gobbyo/picodistance/README.md

# picodistance
Pico driven distance measure

Table of Contents

1. [Overview](docs/overview.md)
1. [Parts List](docs/partslist.md)
1. [Assembly](docs/assembly.md)
