gobbyo/picodistance/docs/images/connectors.png

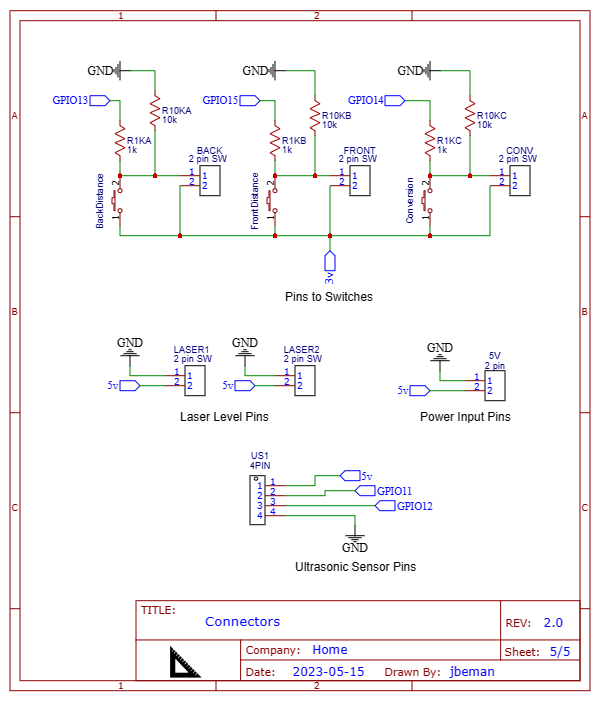
docs/images/connectors.png
