gobbyo/picodistance/docs/images/feet display.png

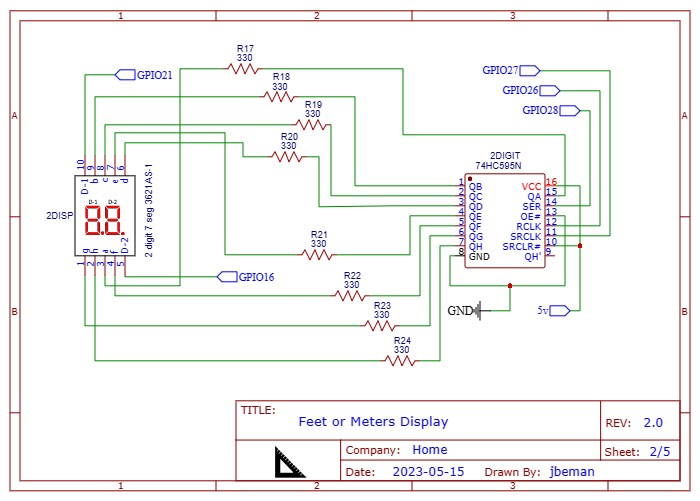
docs/images/feet display.png
