gobbyo/picodistance/docs/images/fourdigitsimple.png

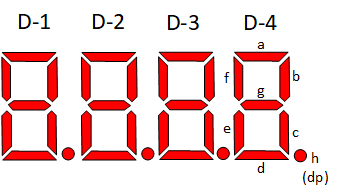
docs/images/fourdigitsimple.png
