gobbyo/picodistance/docs/images/inches display.png

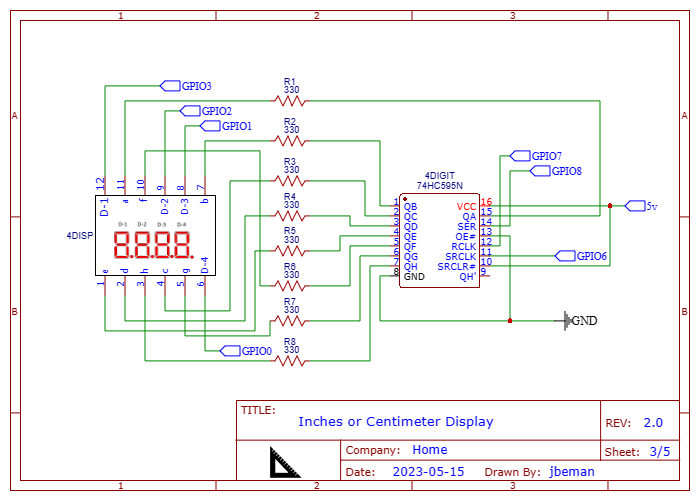
docs/images/inches display.png
