gobbyo/picodistance/docs/images/pcbbottom.png

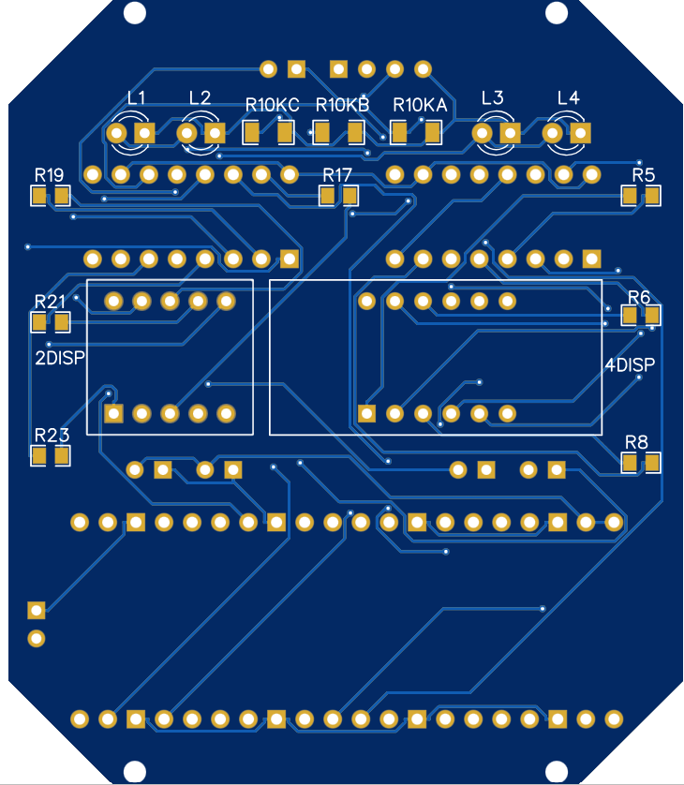
docs/images/pcbbottom.png
