gobbyo/picodistance/docs/images/pcbdimensions.png

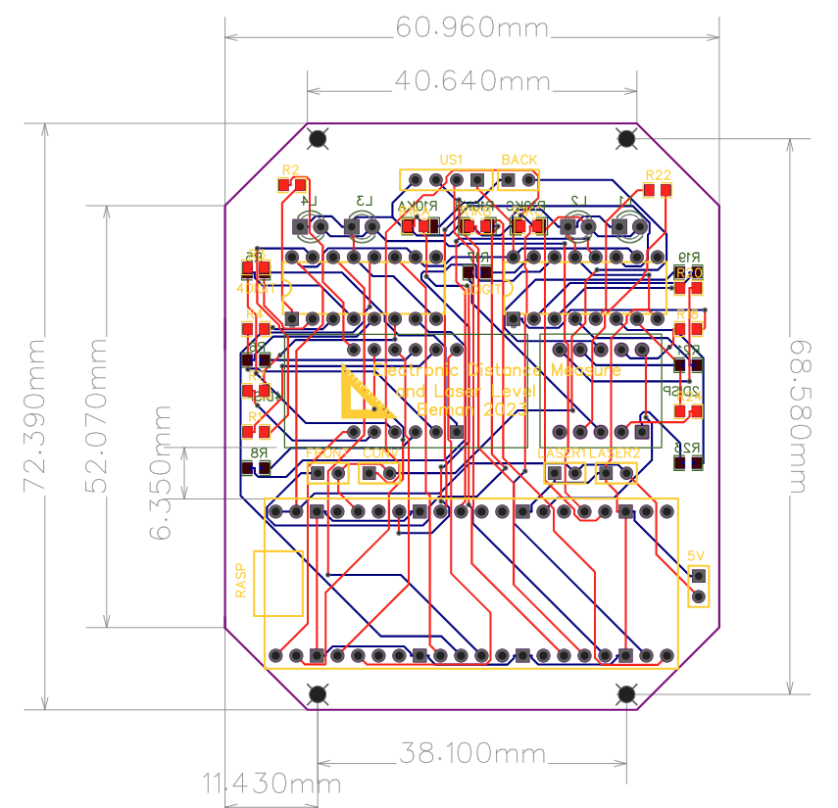
docs/images/pcbdimensions.png
