gobbyo/picodistance/docs/images/pcbtop.png

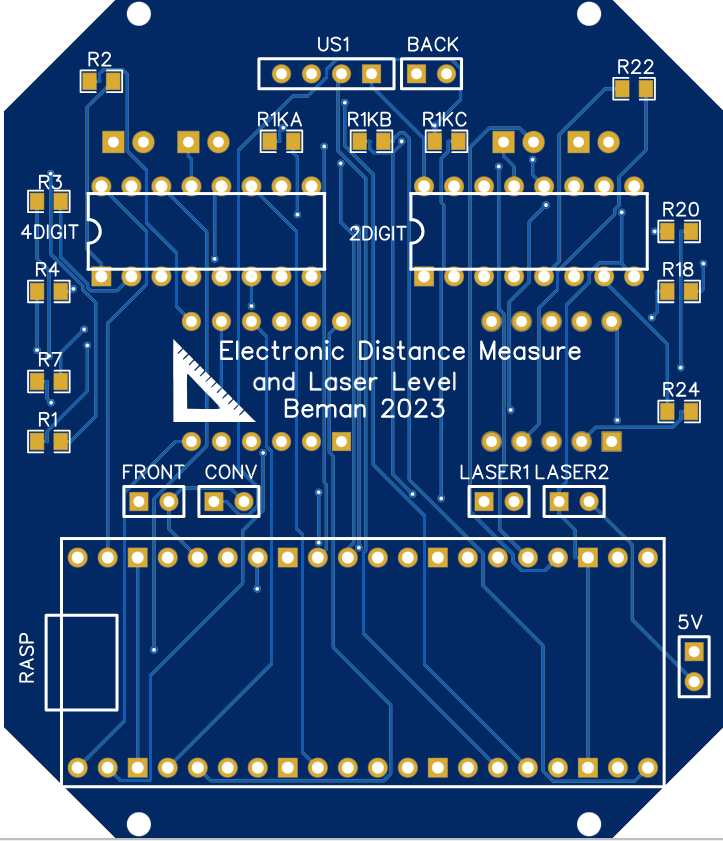
docs/images/pcbtop.png
