gobbyo/picodistance/docs/images/twodigitsimple.png

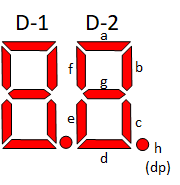
docs/images/twodigitsimple.png
