gobbyo/picodistance/docs/images/ultrasonic and battery.png

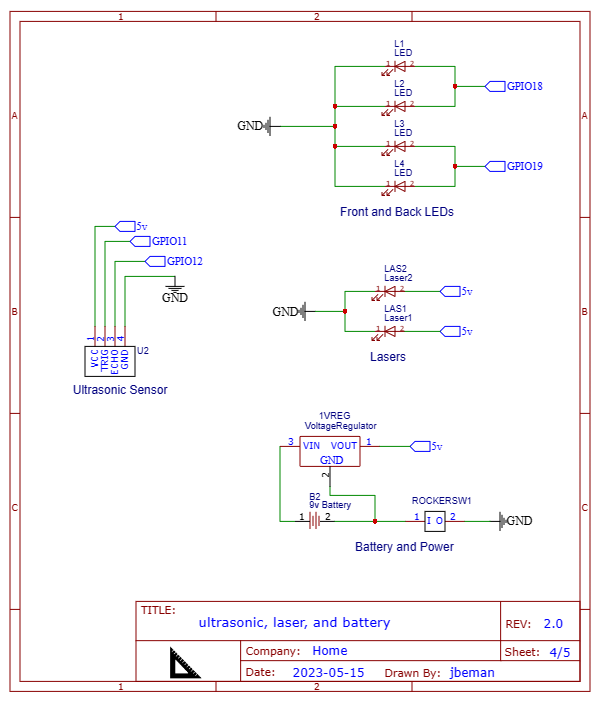
docs/images/ultrasonic and battery.png
