gobbyo/picodistance/pcb/distance-back-2023-08-4.png

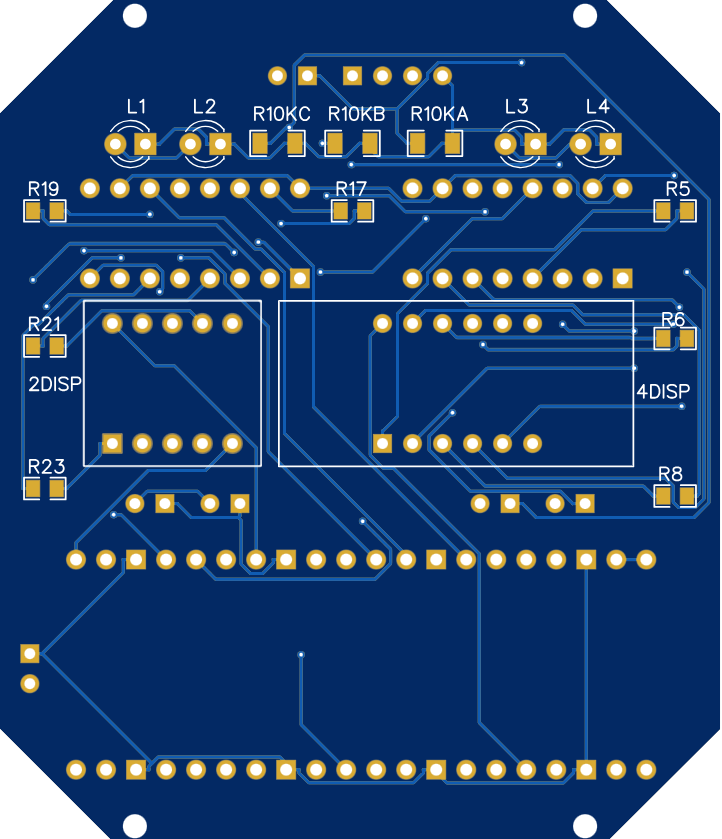
pcb/distance-back-2023-08-4.png
