gobbyo/picodistance/pcb/distance-front-2023-08-4.png

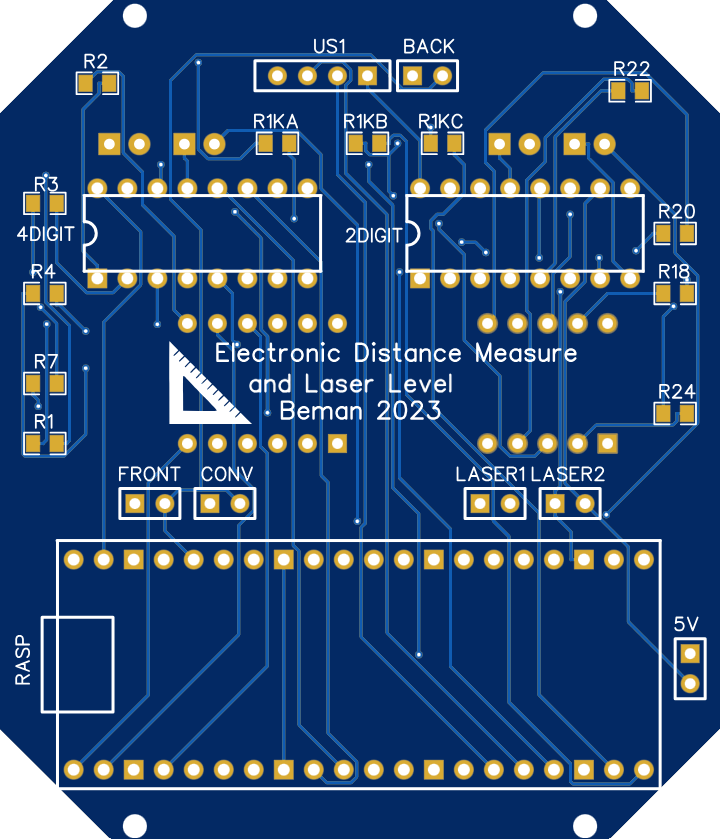
pcb/distance-front-2023-08-4.png
