gobbyo/picodistance/docs/partslist.md

# Parts List

|Item  |Model  |Quantity  |Datasheet  |
|---|---|---|---|
| Raspberry Pi Pico  | RP2040 | 1 | https://www.raspberrypi.com/products/raspberry-pi-pico/ |
| Printed Circuit Board | N/A | 1 | See PCB ordering instructions |
| LED 2-Digit 7-Segment Display 0.36"  | 3621AS | 1 | http://www.xlitx.com/datasheet/3621AS.pdf |
| LED 4-Digit 7-Segment Display 0.36" | 3641AH | 1 | http://www.xlitx.com/datasheet/3641AH.pdf |
| 5vDC voltage regulator | 7805 | 1 | https://www.eleccircuit.com/7805-5v-voltage-regulator-datasheet/ |
| 3MM flat top white LED | AA00136 |  4 | https://www.aliexpress.us/item/2251832094868310.html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 |
|Laser Transmitter 5mW 650nm Red Dot Laser Diode Module | KY-008 | 2 | https://temperosystems.com.au/products/ky-008-laser-650nm-5v-laser-diode-laser-transmitter/ |
| 8-Bit Counter Shift Registers 3-State Output Registers Integrated Circuits DIP-16  | SN74HC595N |  2 | https://www.apogeeweb.net/circuitry/sn74hc595n-pinout-datasheet-features-applications.html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 |
|Ultrasonic Module HC-SR04 Distance Sensor | HC-SR04 |  1 | https://mega.nz/folder/BlJz0T7B#dzXcwUN_xoUTOmhmVMA0sg/folder/E5BFULaB |
|12MM Momentary Push Button Switch (ON/Off) Mini Round Switch SPST 2 Pin  |  PBS-33B-M-6S | 2 | |
| Mini Level Picture Hanging Spirit Bubble Level, 10x10x29mm Square Level Mark Measuring Tool | 43338-2313 |  2 | N/A |
| Mini Rocker Switch T85 2 Pin SPST Small ON and Off Rocker Toggle KCD1 Switch | KCD1-101 | 1 | https://www.chinadaier.com/kcd1-101-10-amp-rocker-switch/ |
|M2 tapping screws  | M2 | 16 | N/A  |
|Surface Mounted Devices Chip Resistor, 330 Ohm 1/8W 0805 Fixed Resistors  | a19030500ux0300 | 16 |  N/A |
|Surface Mounted Devices Chip Resistor, 220 Ohm 1/10W Fixed Resistors | pta220823tt0324 | 2 | N/A |
