gobbyo/picodistance/3dprint/electricmeasure-part-laserholder.stl

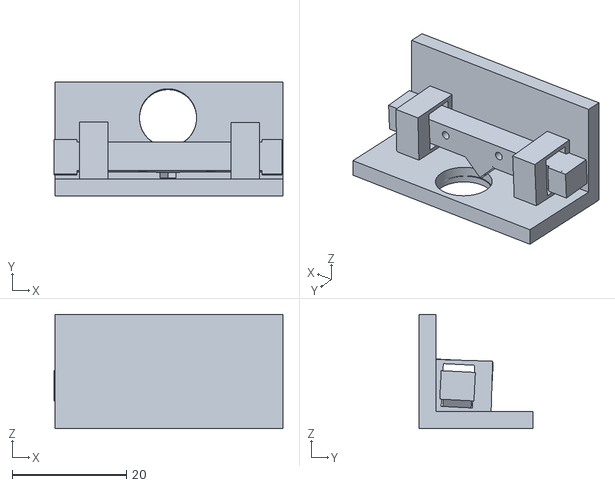
[picture p12: CAD file, 2023-11-16]
3dprint/electricmeasure-part-laserholder.stl
40.2 x 20.0 x 20.0
