gobbyo/picodistance/3dprint/electricmeasure-parts-front.stl

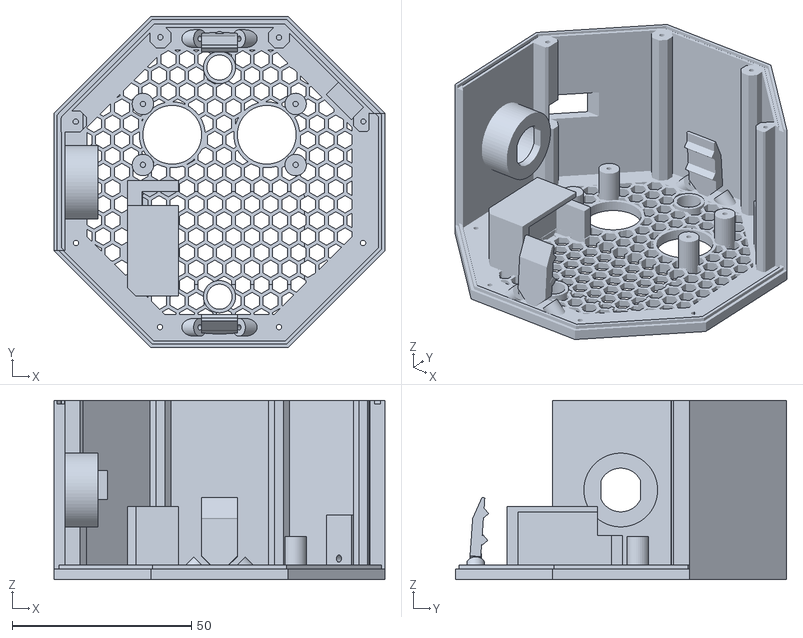
[picture p13: CAD file, 2023-08-09]
3dprint/electricmeasure-parts-front.stl
92.4 x 92.4 x 50.0
