gobbyo/picodistance/3dprint/electricmeasure-parts-back.stl

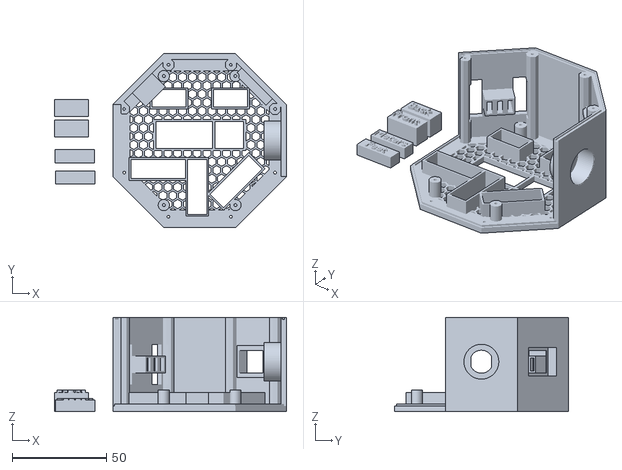
[picture p14: CAD file, 2023-08-09]
3dprint/electricmeasure-parts-back.stl
123.4 x 92.5 x 50.0
