gobbyo/picodistance/3dprint/electricmeasure-test.stl

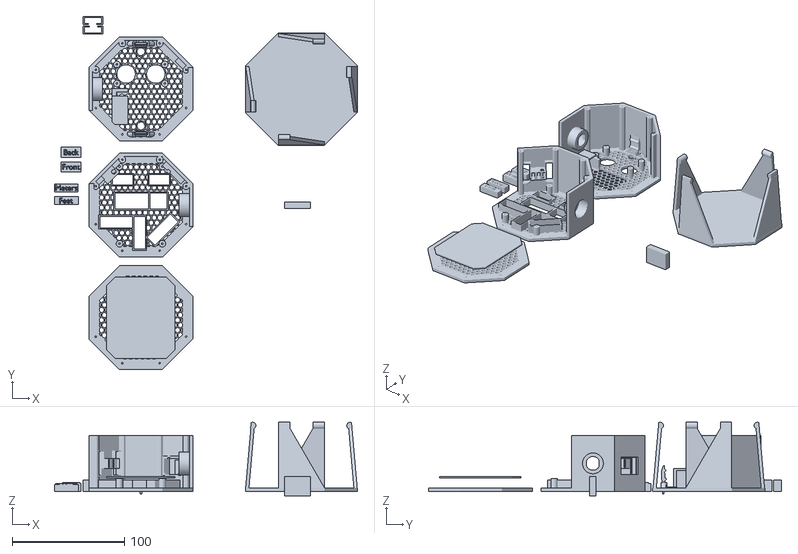
[picture p15: CAD file, 2023-08-05]
3dprint/electricmeasure-test.stl
269.5 x 313.9 x 65.4
