gobbyo/picodistance/3dprint/testimage.obj

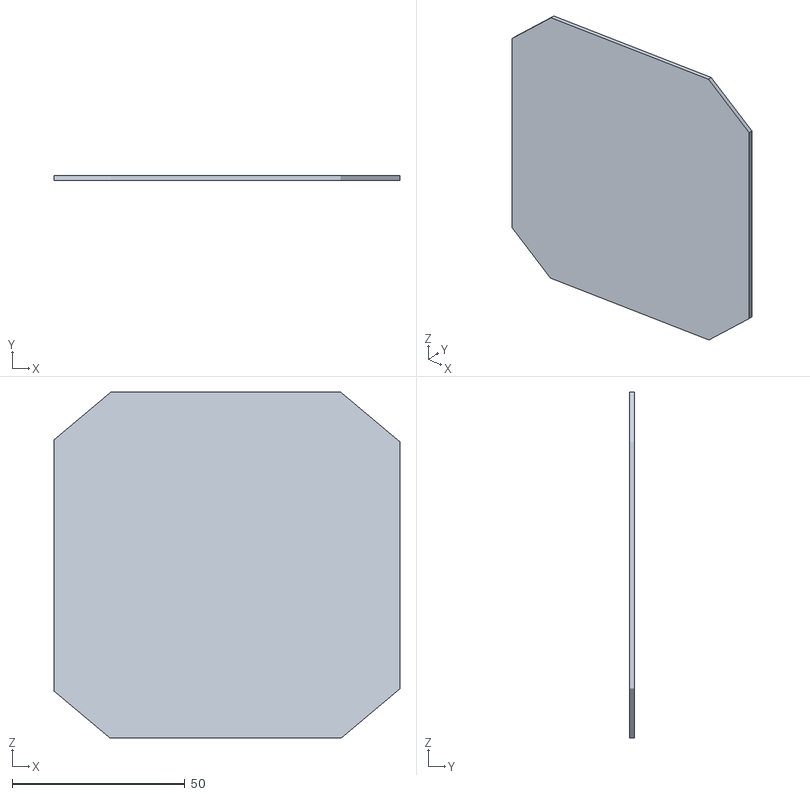
[picture p16: CAD file, 2023-08-05]
3dprint/testimage.obj
100.0 x 1.50 x 100.0
