gobbyo/picodistance/3dprint/electricmeasure-parts-paddle.stl

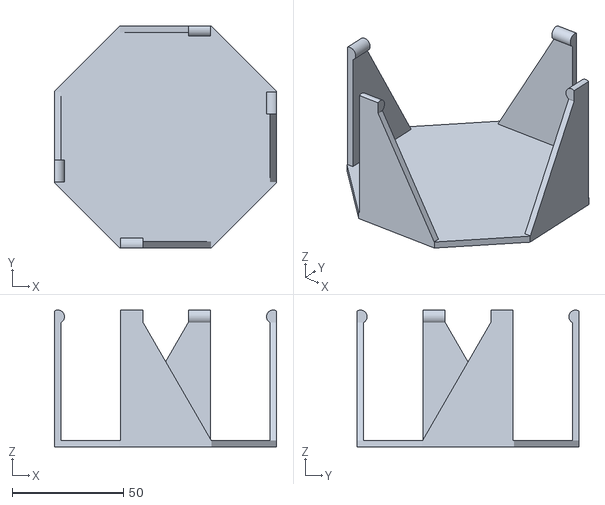
[picture p17: CAD file, 2023-06-04]
3dprint/electricmeasure-parts-paddle.stl
99.9 x 99.8 x 61.6
