gobbyo/picodistance/3dprint/electricmeasure-parts-frontbackinserts.stl

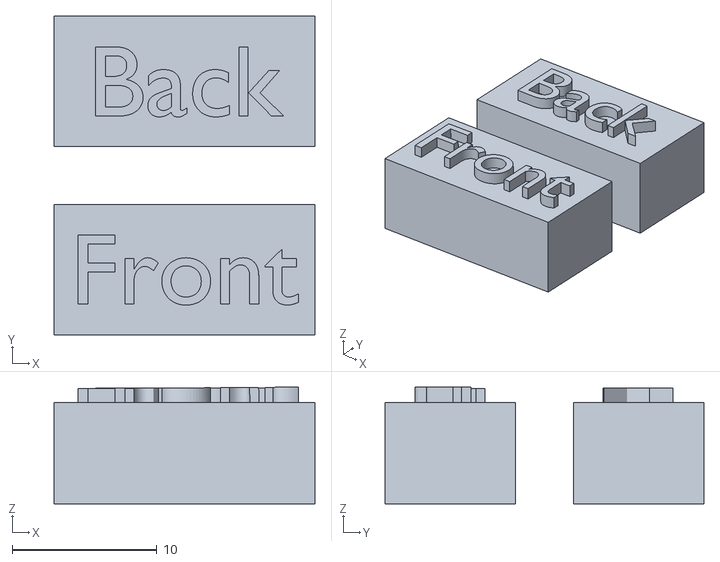
[picture p18: CAD file, 2023-06-04]
3dprint/electricmeasure-parts-frontbackinserts.stl
18.0 x 22.0 x 8.06
