gobbyo/picodistance/3dprint/electricmeasure.stl

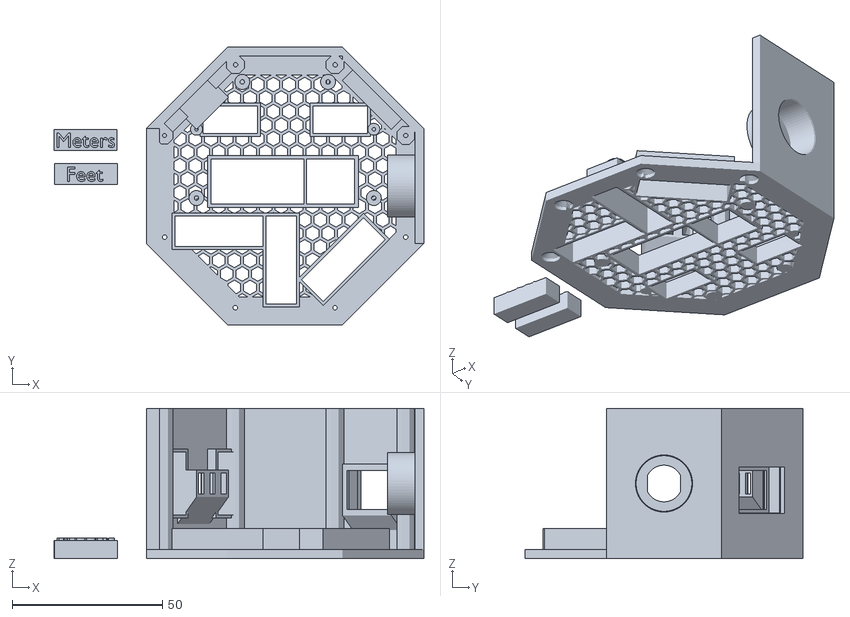
[picture p19: CAD file, 2023-06-04]
3dprint/electricmeasure.stl
123.1 x 92.4 x 50.0
