gobbyo/picodistance/3dprint/electricmeasure-parts-front-brackets.stl

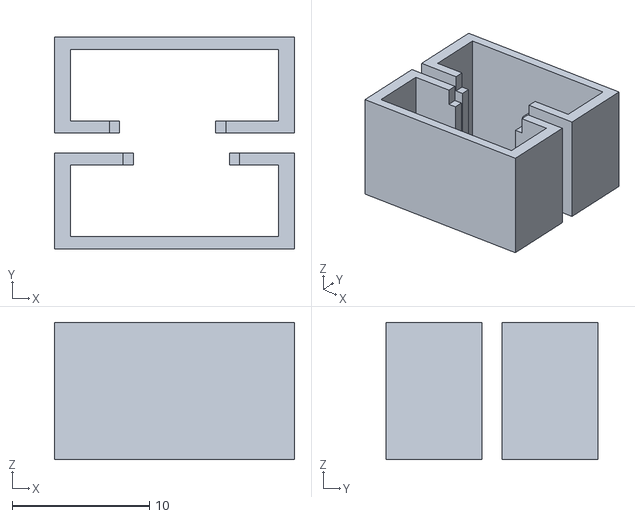
[picture p20: CAD file, 2023-06-04]
3dprint/electricmeasure-parts-front-brackets.stl
17.5 x 15.4 x 10.0
