gobbyo/picodistance/3dprint/electricmeasure-parts-backinserts.stl

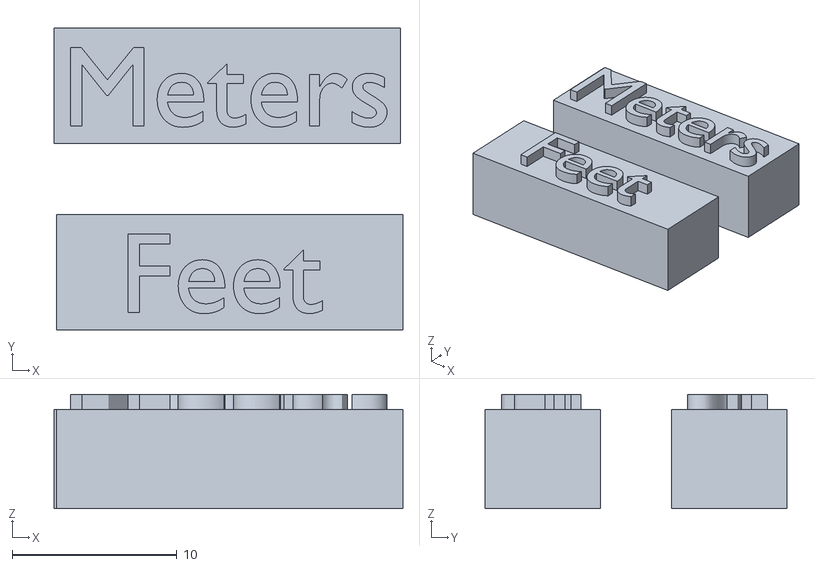
[picture p21: CAD file, 2023-06-04]
3dprint/electricmeasure-parts-backinserts.stl
21.2 x 18.3 x 6.92
