gobbyo/picodistance/3dprint/electricmeasure-parts.stl

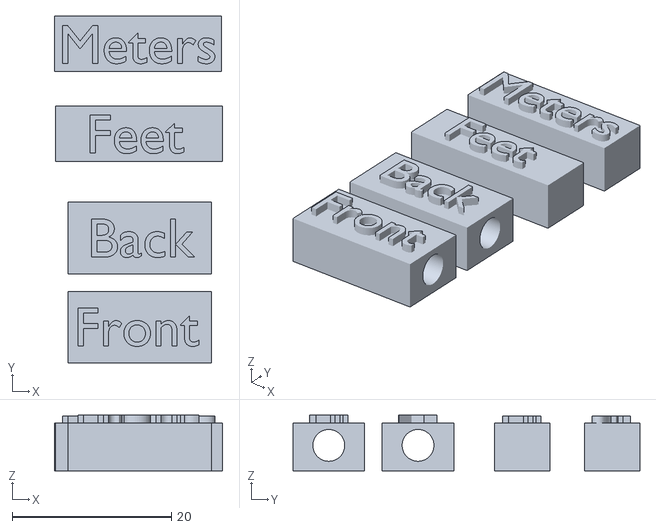
[picture p22: CAD file, 2023-05-22]
3dprint/electricmeasure-parts.stl
21.2 x 43.6 x 7.00
