gobbyo/picodistance/(list of files, cad)

Other CAD files:
3dprint/electricmeasure-part-laserholder.blend
3dprint/electricmeasure-parts-back.blend
3dprint/electricmeasure-parts-backinserts.blend
3dprint/electricmeasure-parts-front-brackets.blend
3dprint/electricmeasure-parts-front.blend
3dprint/electricmeasure-parts-frontbackinserts.blend
3dprint/electricmeasure-parts-paddle.blend
3dprint/electricmeasure-parts.blend
3dprint/electricmeasure.blend
3dprint/testimage.blend
