gobbyo/picodistance/docs/images/distance measure.png

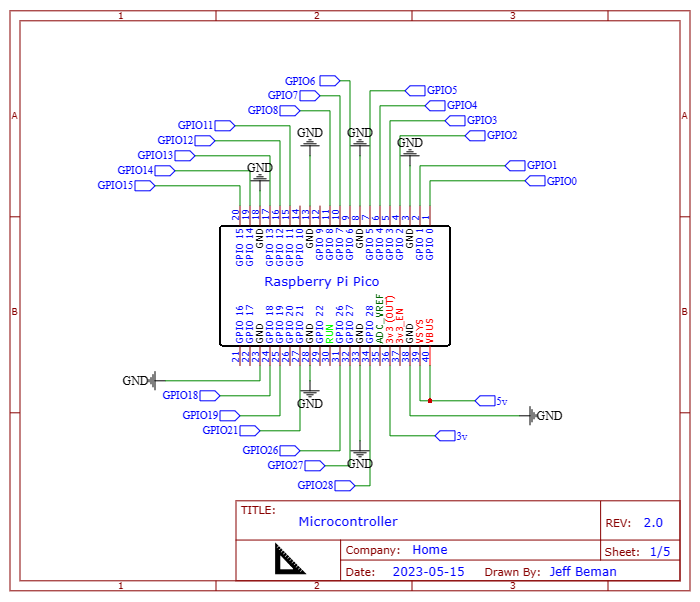
docs/images/distance measure.png
