gobbyo/picodistance/docs/Schematic_DistanceMeasure_2023-05-23.pdf

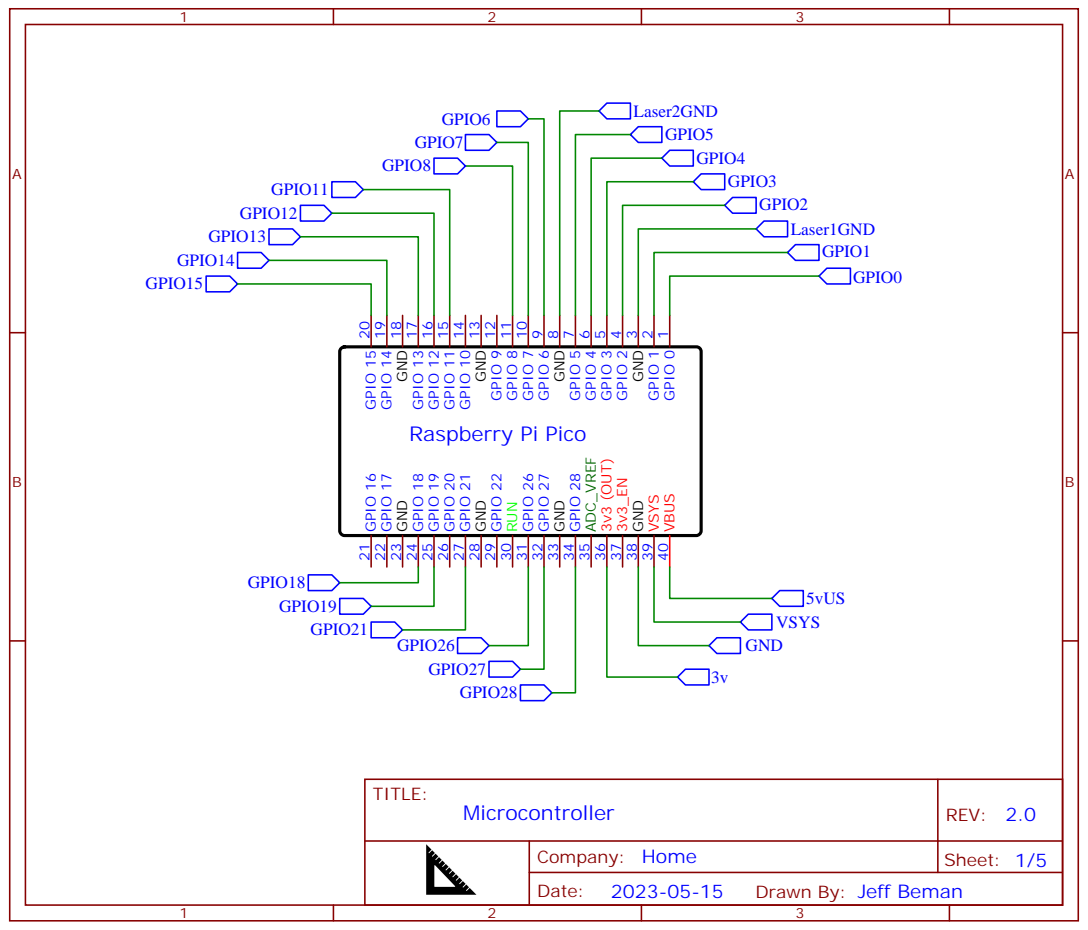
[picture p24: page 1]

9 GPIO 7 10 GPIO 8 11 GPIO 9 12 GND 13 GPIO 10 14 GPIO 11 15 GPIO 12 16 GPIO 13 17 GND 18 GPIO 14 19 GPIO 15 20 GPIO 16 21 GPIO 17 22 GND 23 GPIO 18 24 GPIO 19 25 GPIO 20 26 GPIO 21 27 GND 28 GPIO 22 29 RUN 30 GPIO 26 31 GPIO 27 32

Drawn By: Jeff Beman

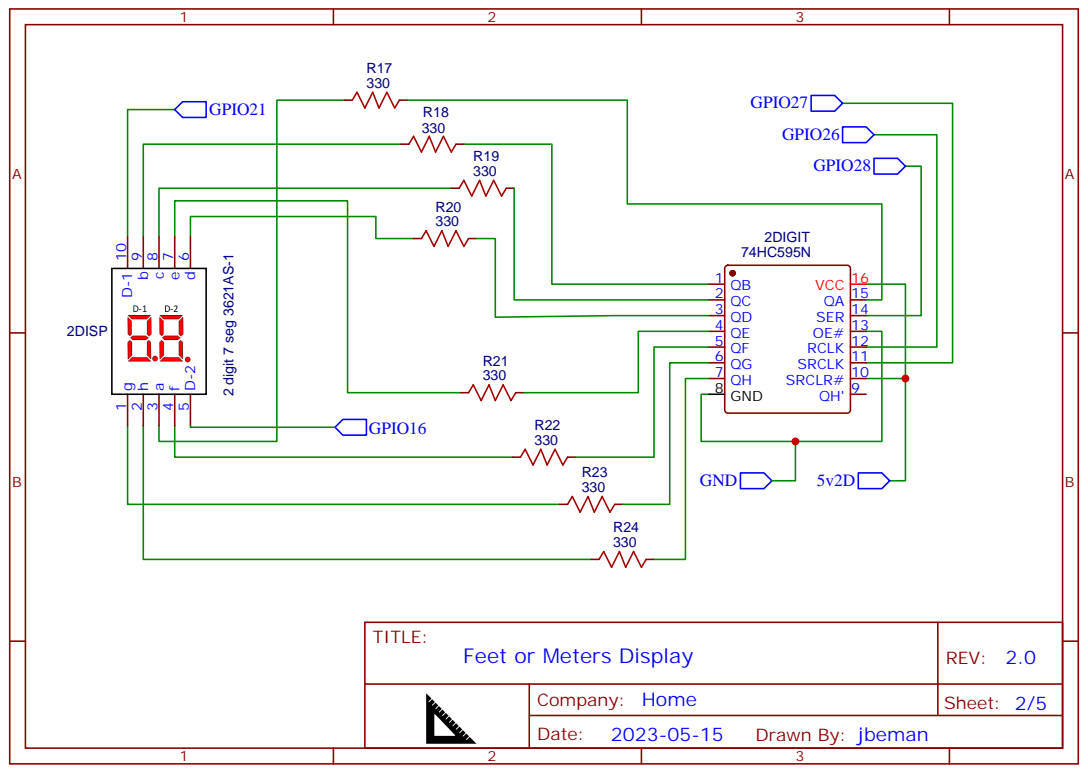
[picture p25: page 2]

SRCLR# 10 SRCLK 11 RCLK 12 OE# 13 SER 14 QA 15 VCC 16

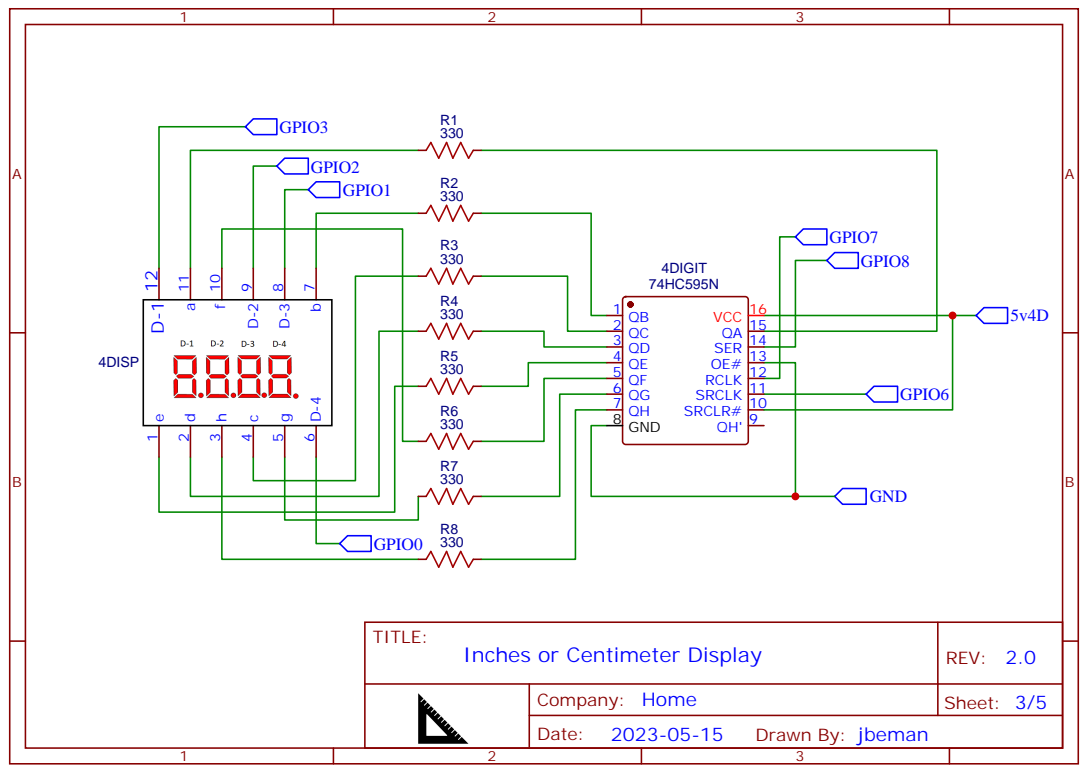
[picture p26: page 3]

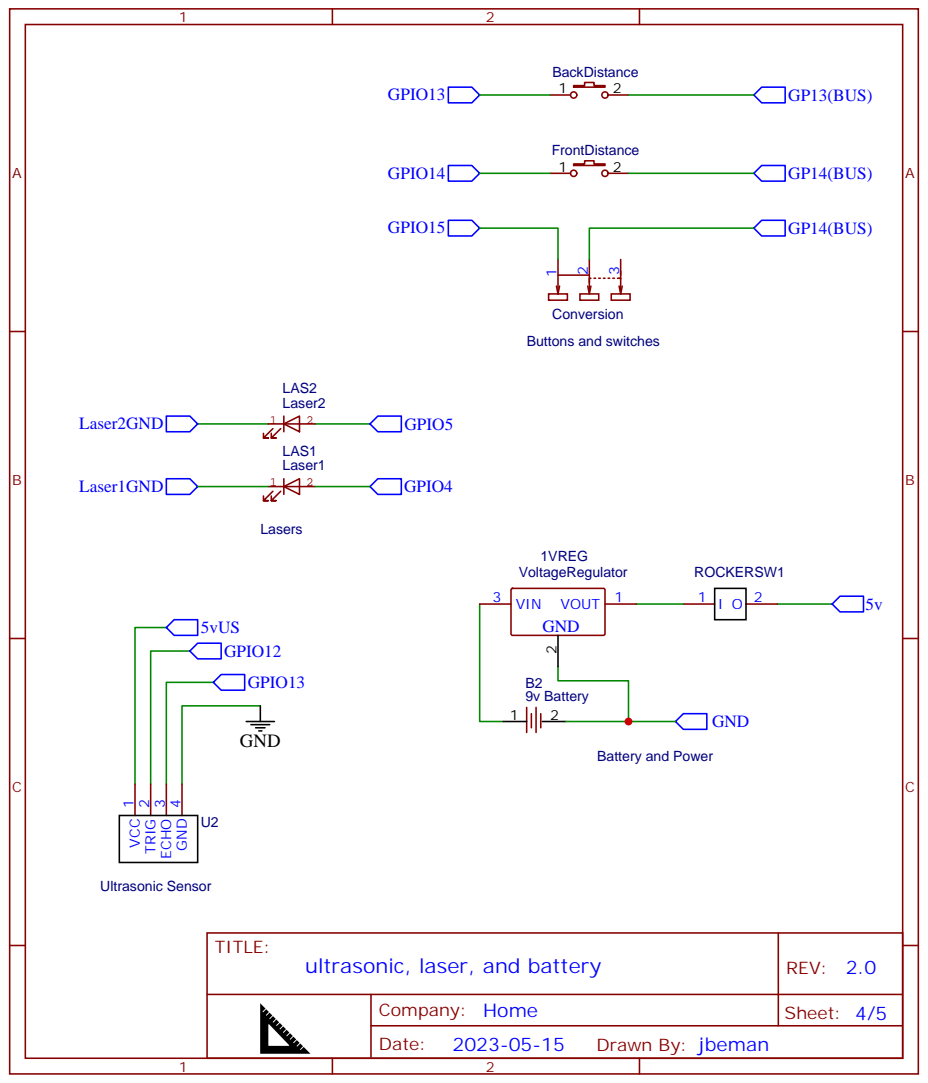
[picture p27: page 4]

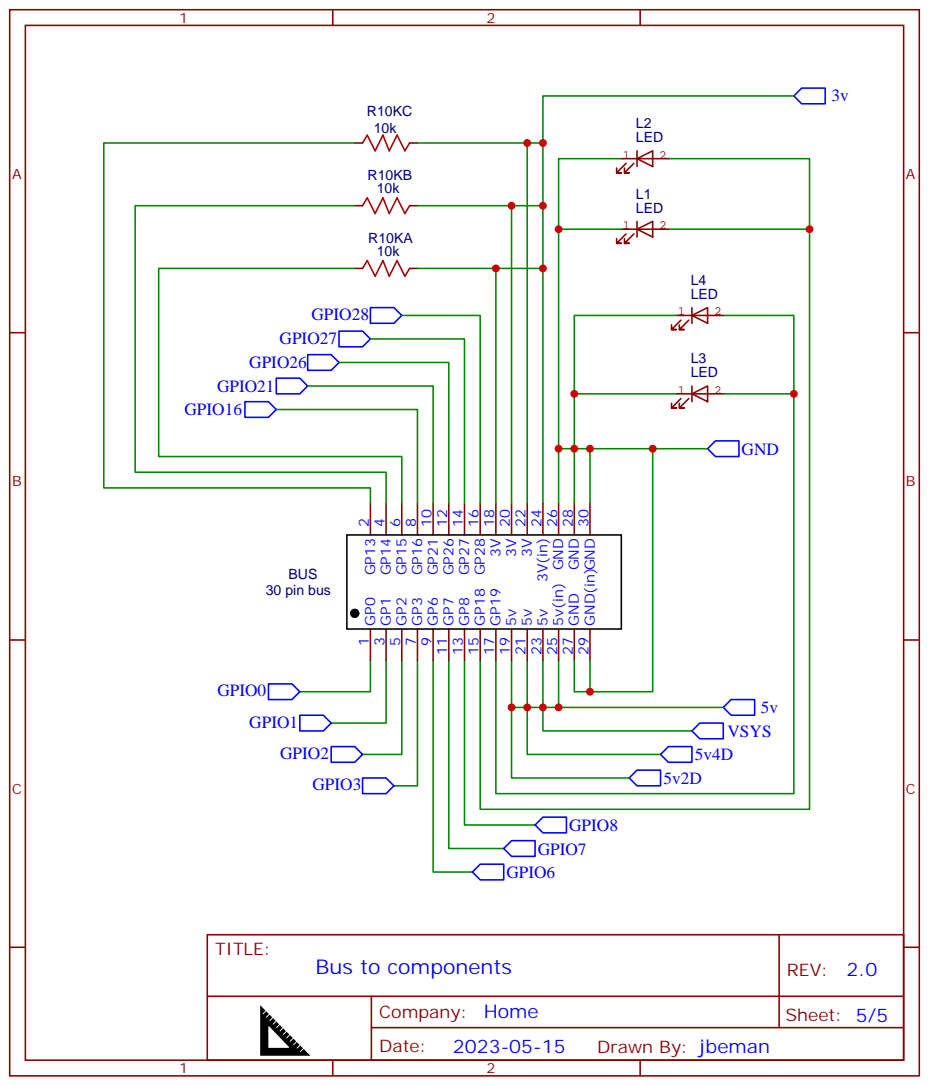
[picture p28: page 5]

GND 30 GND 27 GND(in) 29
