gobbyo/picodistance/python/main.py

from machine import Pin
import time

waitreps = const(20)
waitonpaint = 0.004
millimeters = const(0.001)
ultrasoundlimit = const(4572) #set to 15 feet (in millimeters) based on the spec sheet.
segnum = [0x3F,0x06,0x5B,0x4F,0x66,0x6D,0x7D,0x07,0x7F,0x67]
speedofsound = const(343) # meters per second

triggerpin = const(11)
echopin = const(12)
conversionbuttonpin = const(15)
frontdistancebuttonpin = const(14)

twodigitpins = [21,16]
fourdigitpins = [3,2,1,0]

fourlatchpin = const(7) #RCLK
fourclockpin = const(6) #SRCLK
fourdatapin = const(8) #SER
twolatchpin = const(26) #RCLK
twoclockpin = const(27) #SRCLK
twodatapin = const(28) #SER

class distancestringtools(object):

    def __init__(self):
        self.totalmillimeters = 0
        self.millitoinch = 0.0393701
        self.s_meters = "0"
        self.meters = 0
        self.s_centimeters = "0"
        self.centimeters = 0
        self.s_feet = "0"
        self.feet = 0
        self.s_inches = "0"
        self.inches = 0
    
    def set(self, milli):
        if milli > 0:
            self.totalmillimeters = milli
            s = "{0}".format(milli / 1000)
            n = s.split('.')
            self.s_meters = "{0}".format(n[0])
            self.meters = int(n[0])
            self.centimeters = (milli - (self.meters * 1000)) / 10
            self.s_centimeters = "{0}".format(self.centimeters)

            totalinches = float(milli) * self.millitoinch
            s = "{0}".format(totalinches / 12.0)
            n = s.split('.')
            self.s_feet = "{0}".format(n[0])
            self.feet = int(n[0])
            self.inches = float(totalinches - (float(self.feet) * 12.0))
            self.s_inches = "{0}".format(self.inches)
        
class segdisplays:
    def __init__(self):
        self.twodigits = []
        for d in twodigitpins:
            pin = Pin(d, Pin.OUT)
            pin.high()
            self.twodigits.append(pin)
        self. fourdigits = []

        for d in fourdigitpins:
            pin = Pin(d, Pin.OUT)
            pin.high()
            self.fourdigits.append(pin)
        
        self.fourlatch = Pin(fourlatchpin, Pin.OUT)
        self.fourclock = Pin(fourclockpin, Pin.OUT)
        self.fourdata = Pin(fourdatapin, Pin.OUT)
            
        self.twolatch = Pin(twolatchpin, Pin.OUT)
        self.twoclock = Pin(twoclockpin, Pin.OUT)
        self.twodata = Pin(twodatapin, Pin.OUT)
    
    def __del__(self):
        for t in self.twodigits:
            self.setregister(0,self.twolatch,self.twoclock,self.twodata)
            t.low()
        for f in self.fourdigits:
            self.setregister(0,self.fourlatch,self.fourclock,self.fourdata)
            f.low()

    def getArray(self,val):
        a = [0,0,0,0,0,0,0,0]
        i = 0
        for s in a:
            a[i] = (val & (0x01 << i)) >> i
            i += 1
        return a

    def setregister(self,val,latch,clock,data):
        input = [0,0,0,0,0,0,0,0]
        #open latch for data
        clock.low()
        latch.low()
        clock.high()

        input = self.getArray(val)

        #load data in register
        for i in range(7, -1, -1):
            clock.low()
            if input[i] == 1:
                data.high()
            else:
                data.low()
            clock.high()

        #close latch for data
        clock.low()
        latch.high()
        clock.high()

    def paintdigit(self,val,digit,latch,clock,data):
        digit.low()
        #display the value
        self.setregister(val,latch,clock,data)
        #wait to see it
        time.sleep(waitonpaint)
        #clear the display
        self.setregister(0,latch,clock,data)
        digit.high()

    def printnumber(self,d):
        if d < 99:
            num = "{0}".format(d)
            d = len(self.twodigits)-1
            i = len(num)-1
            while i >= 0 & d >= 0:
                if(num[i].isdigit()):
                    val = segnum[int(num[i])]
                    self.paintdigit(val,self.twodigits[d],self.twolatch,self.twoclock,self.twodata)
                    d -= 1
                i -= 1

    def printfloat(self,f):
        if f < 100: 
            num = "{:.2f}".format(f)
            i = len(num)-1
            decimal = False
            d = 3
            while i >= 0 & d >= 0:
                if(num[i].isdigit()):
                    val = segnum[int(num[i])]
                    if decimal:
                        val |= 0x01 << 7
                        decimal = False
                    self.paintdigit(val,self.fourdigits[d],self.fourlatch,self.fourclock,self.fourdata)
                    d -= 1
                else:
                    decimal = True
                i -= 1

def getdistancemeasure():
    print("getdistancemeasure")

    trig = Pin(triggerpin,Pin.OUT)
    echo = Pin(echopin,Pin.IN,Pin.PULL_DOWN)

    receive = 0
    send = 0

    trig.low()
    time.sleep(.002)
    trig.high()
    time.sleep(.002)
    trig.low()
    
    while echo.value() == 0:
        pass
    send = time.ticks_us()

    while echo.value() == 1:
        pass
    receive = time.ticks_us()

    timepassed = receive - send

    distanceinmillimeters = 0

    if timepassed > 0:
        distanceinmillimeters = round((timepassed * speedofsound * millimeters) / 2)
    
    if (distanceinmillimeters > ultrasoundlimit):
        distanceinmillimeters = 0
    
    print("distanceinmillimeters = {0}".format(distanceinmillimeters))
    
    trig.low()

    return distanceinmillimeters

def main():   

    frontdistancebutton=Pin(frontdistancebuttonpin,Pin.IN,Pin.PULL_DOWN)
    conversionbutton=Pin(conversionbuttonpin,Pin.IN,Pin.PULL_DOWN)
    display = segdisplays()

    try:
        d = 0
        distance = distancestringtools()

        while True:
            if frontdistancebutton.value():
                print("frontdistancebutton pushed")
                d = getdistancemeasure()

            distance.set(d)

            if conversionbutton.value():   
                print("meters")           
                for w in range(waitreps):
                    display.printnumber(distance.meters)
                    display.printfloat(distance.centimeters)
            else:
               print("feet") 
               for w in range(waitreps):
                    display.printnumber(distance.feet)
                    display.printfloat(distance.inches)

    finally:
        conversionbutton.low()
        frontdistancebutton.low()
        display.__del__()

if __name__ == '__main__':
	main()
