gobbyo/picodistance/(commit log)

2023-04-03 initial checkin
    [electricmeasure-parts.blend, electricmeasure-parts.stl, electricmeasure.blend, electricmeasure.stl, twodigit.fzz]
2023-04-21 updated electronics
    [4dig7segdisplay.blend, electricmeasure-parts-back.blend, electricmeasure-parts-back.stl, electricmeasure-parts-front.blend, electricmeasure-parts-front.stl, electricmeasure-parts.blend, electricmeasure-parts.stl, electricmeasure.blend]
2023-04-27 updated code to include initial circuit test
2023-04-27 added front and back LEDs
2023-04-30 updated startup
    [electricmeasure.blend]
2023-05-01 added initial instructions and parts list
    [partslist.xlsx]
2023-05-02 initial assembly instructions, added timer to autoshutdown after 2 minutes of inactivity
    [electricmeasure.blend]
2023-05-10 updated casing
    [electricmeasure-parts-back.blend, electricmeasure-parts-back.stl, electricmeasure-parts-front.blend, electricmeasure-parts-front.stl, electricmeasure.blend, laserholder.blend, laserholder.stl]
2023-05-17 updated schematic and gerber file
    [electricmeasure-parts-back.blend, electricmeasure-parts-back.stl, electricmeasure-parts-front.blend, electricmeasure-parts-front.stl, electricmeasure.blend, laserholder.blend, laserholder.stl]
2023-05-22 updated test and casing
    [electricmeasure-parts.blend, electricmeasure-parts.stl]
2023-05-22 added switch button class and updated tests accordingly
    [electricmeasure.blend]
2023-05-22 updated to include lasers
2023-05-26 updated pcb info and offsets for ultrasound
2023-06-01 updated pcb
    [electricmeasure-parts-front-brackets.blend, electricmeasure-parts-front-brackets.stl, electricmeasure-parts-front.blend, electricmeasure-parts-front.stl]
2023-06-04 final changes to schematic
    [electricmeasure-parts-back.blend, electricmeasure-parts-back.stl, electricmeasure-parts-backinserts.blend, electricmeasure-parts-backinserts.stl, electricmeasure-parts-front-brackets.stl, electricmeasure-parts-front.blend, electricmeasure-parts-front.stl, electricmeasure-parts-frontbackinserts.blend]
2023-08-05 reworked code to classes and modules
    [electricmeasure-parts-back.blend, electricmeasure-parts-back.stl, electricmeasure-parts-front.blend, electricmeasure-parts-front.stl, electricmeasure-test.stl, testimage.blend, testimage.obj]
2023-08-09 added test files
    [electricmeasure-parts-back.blend, electricmeasure-parts-back.stl, electricmeasure-parts-front.blend, electricmeasure-parts-front.stl]
2023-11-16 updated laser design and added stl
    [electricmeasure-part-laserholder.blend, electricmeasure-part-laserholder.stl]
